lzandberg/SongBeam/Hardware/SongBeam3.1_back.jpg

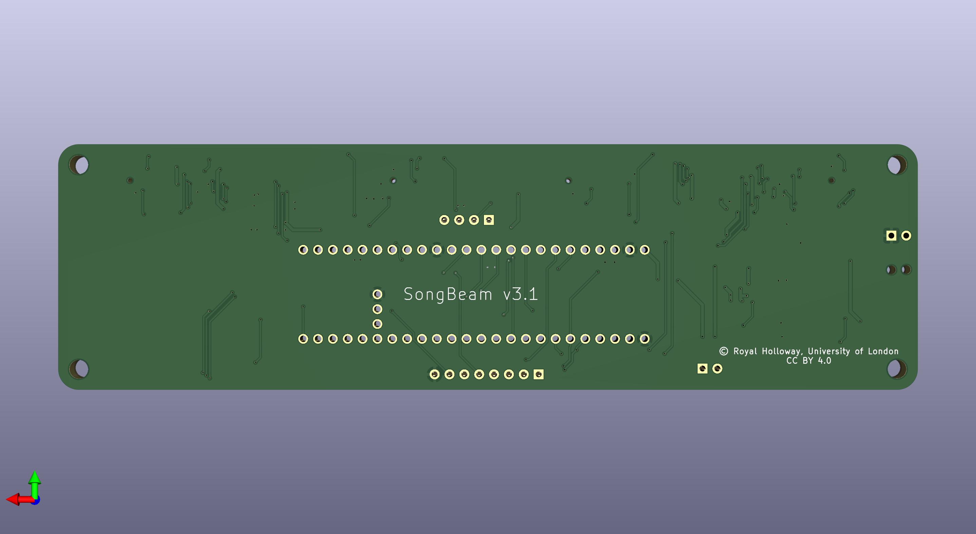
Hardware/SongBeam3.1_back.jpg
