lzandberg/SongBeam/Hardware/SongBeam3.1_front.jpg

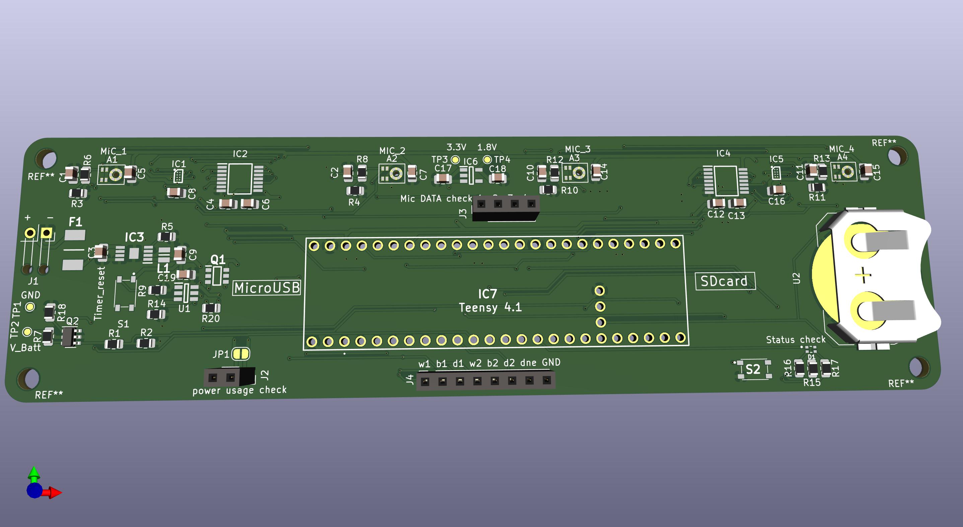
Hardware/SongBeam3.1_front.jpg
