lzandberg/SongBeam/README.md

# SongBeam
Songrecorder using beamforming technology
