lzandberg/SongBeam/Enclosure/IMG_0148.jpg

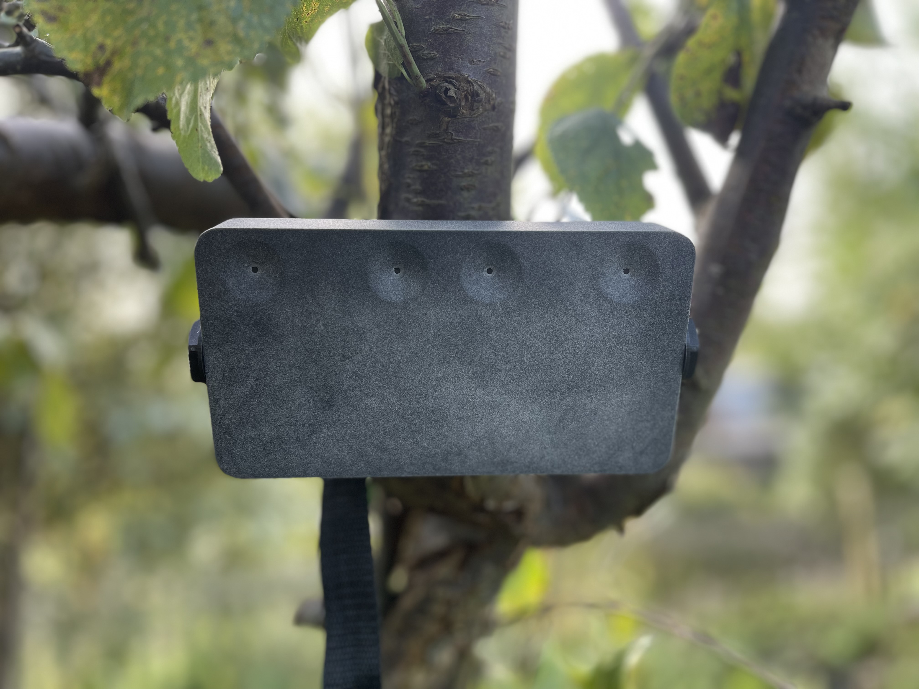
Enclosure/IMG_0148.jpg
