lzandberg/SongBeam/Enclosure/IMG_0149.jpg

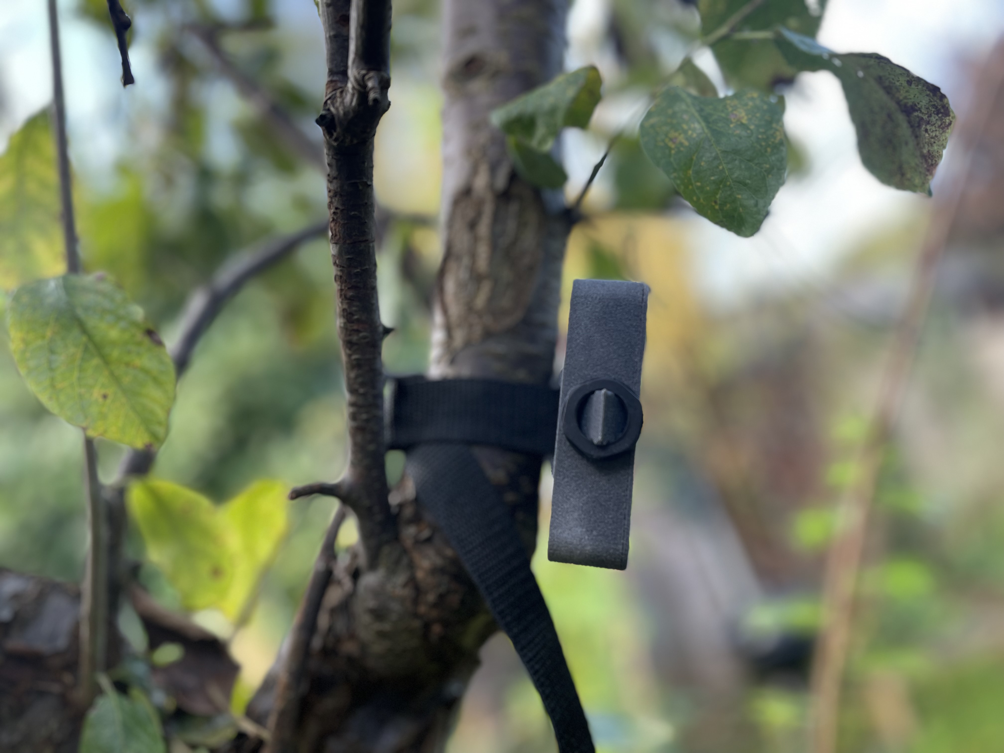
Enclosure/IMG_0149.jpg
