lzandberg/SongBeam/Enclosure/IMG_0150.jpeg

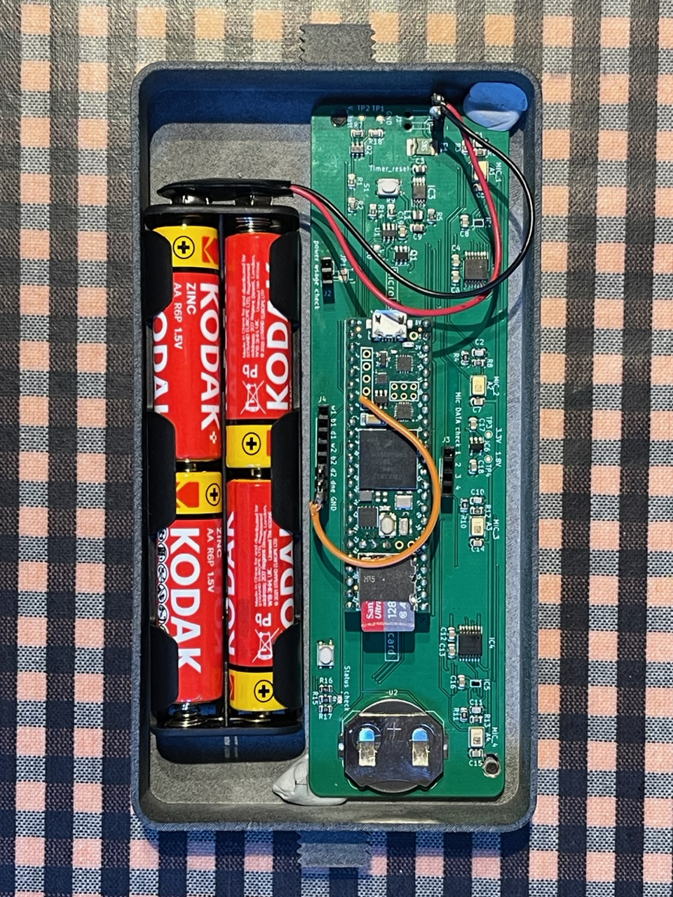
Enclosure/IMG_0150.jpeg
