lzandberg/SongBeam/Enclosure/SongBeam_Enclosure_Base.stl

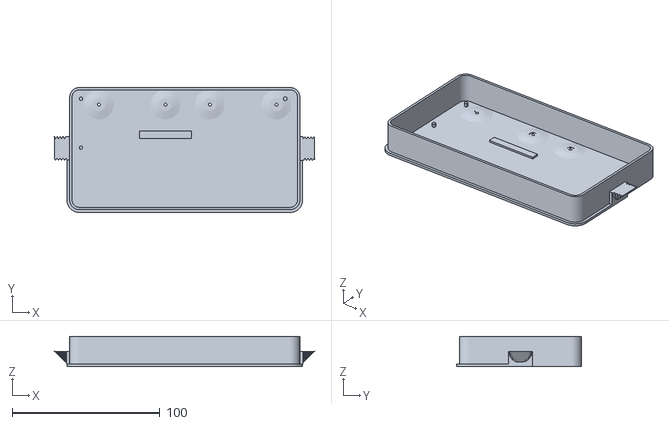
[picture p6: CAD file, 2023-12-08]
Enclosure/SongBeam_Enclosure_Base.stl
175.7 x 84.5 x 20.4
