lzandberg/SongBeam/Enclosure/SongBeam_Enclosure_Lid.stl

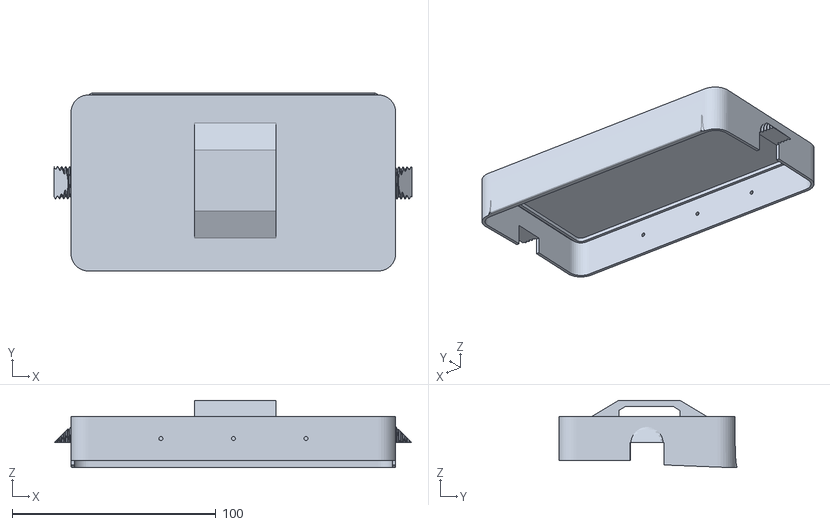
[picture p7: CAD file, 2023-12-08]
Enclosure/SongBeam_Enclosure_Lid.stl
175.7 x 87.4 x 33.1
