lzandberg/SongBeam/Hardware/SongBeam3.1.pdf

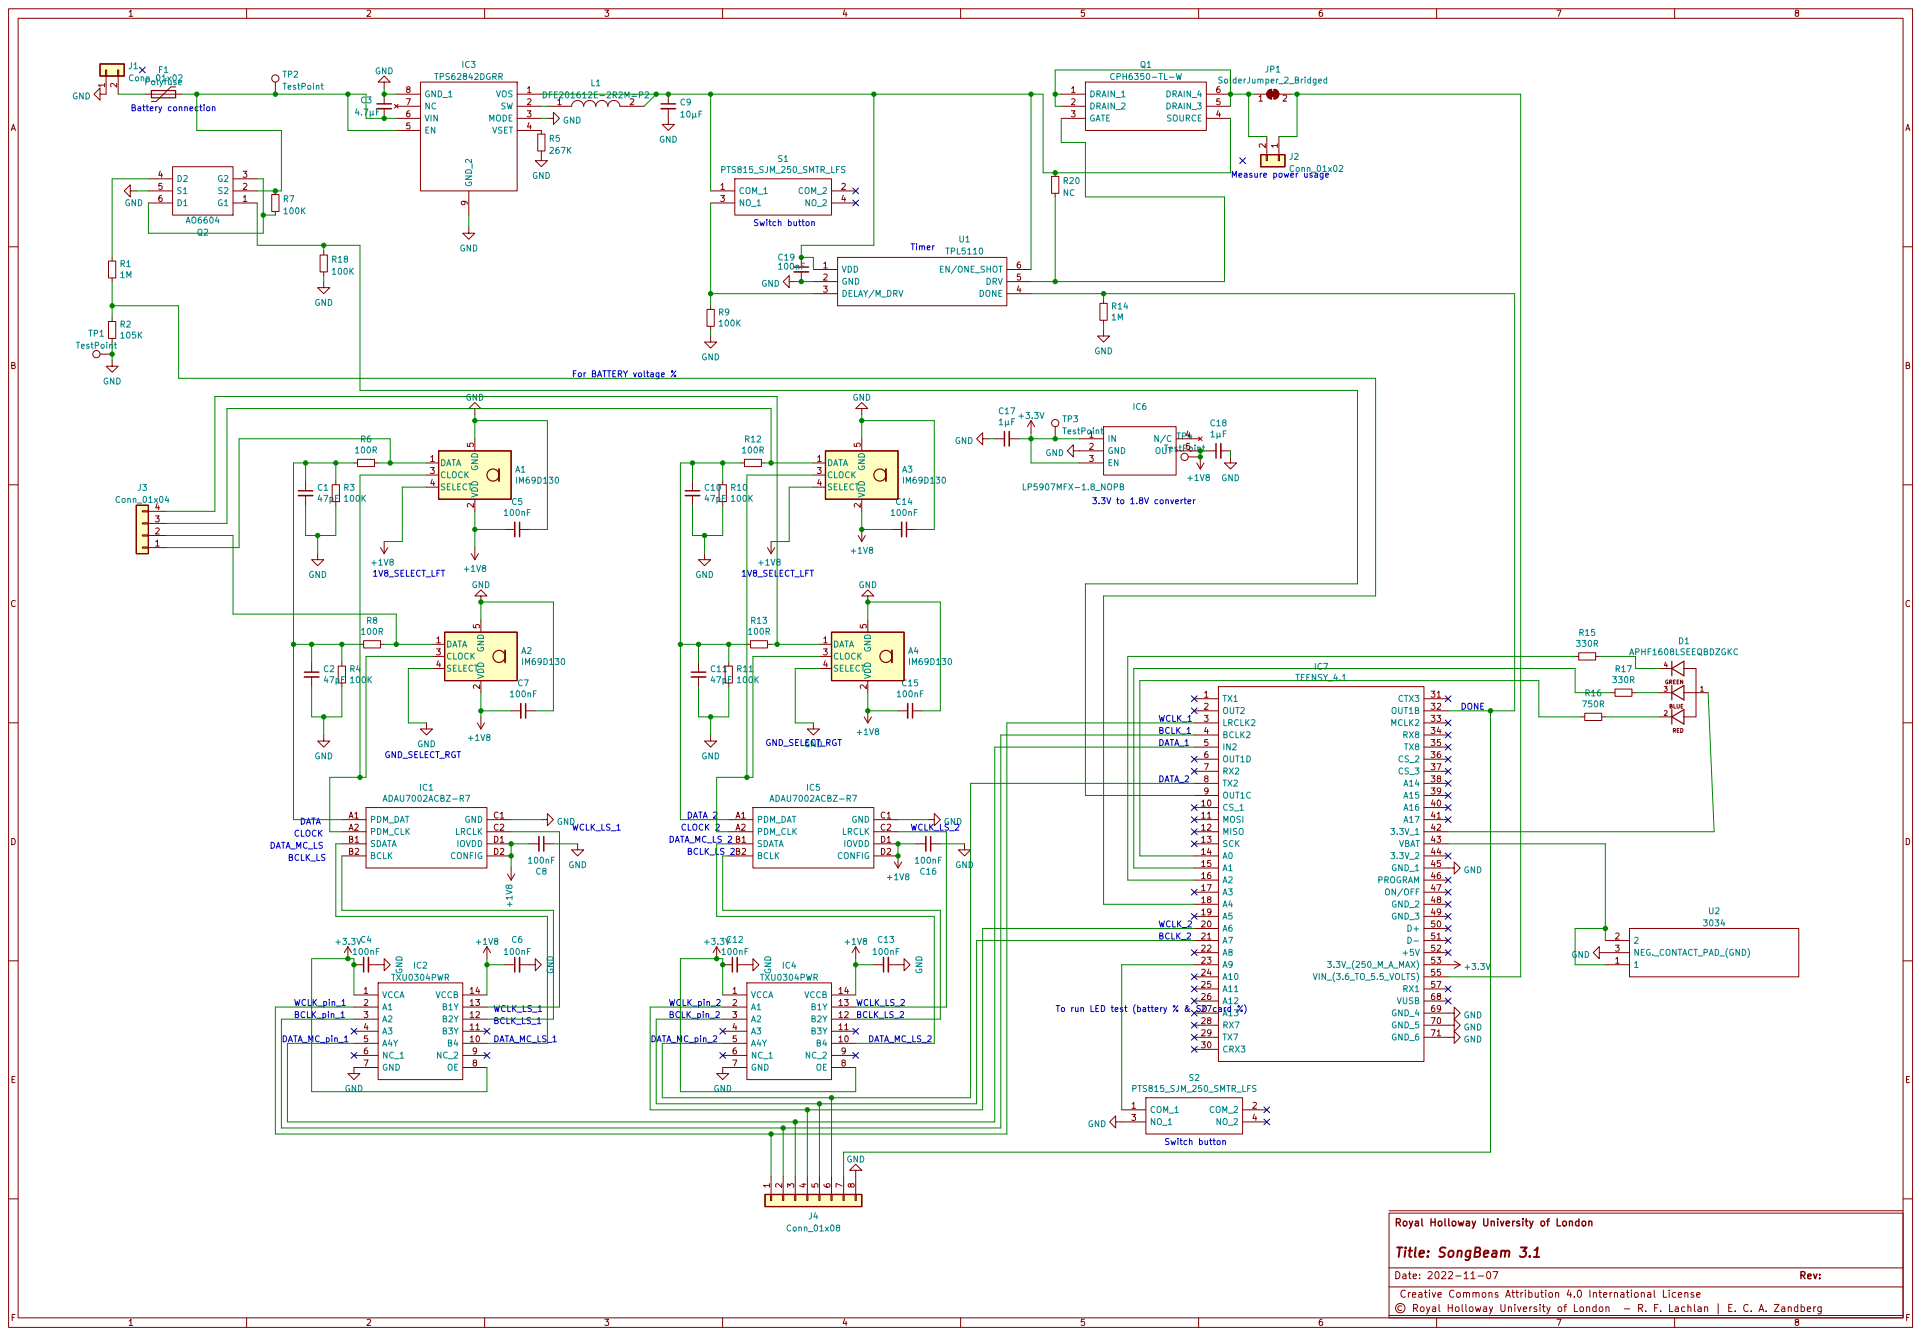
[picture p8: page 1]

To run LED test (battery % & SD card %) BCLK_2 WCLK_2 BCLK_LS 2 BCLK_pin_2

Royal Holloway University of London

Creative Commons Attribution 4.0 International License
