lzandberg/SongBeam/Hardware/SongBeam 3.1_kicad/SongBeam3.1.pdf

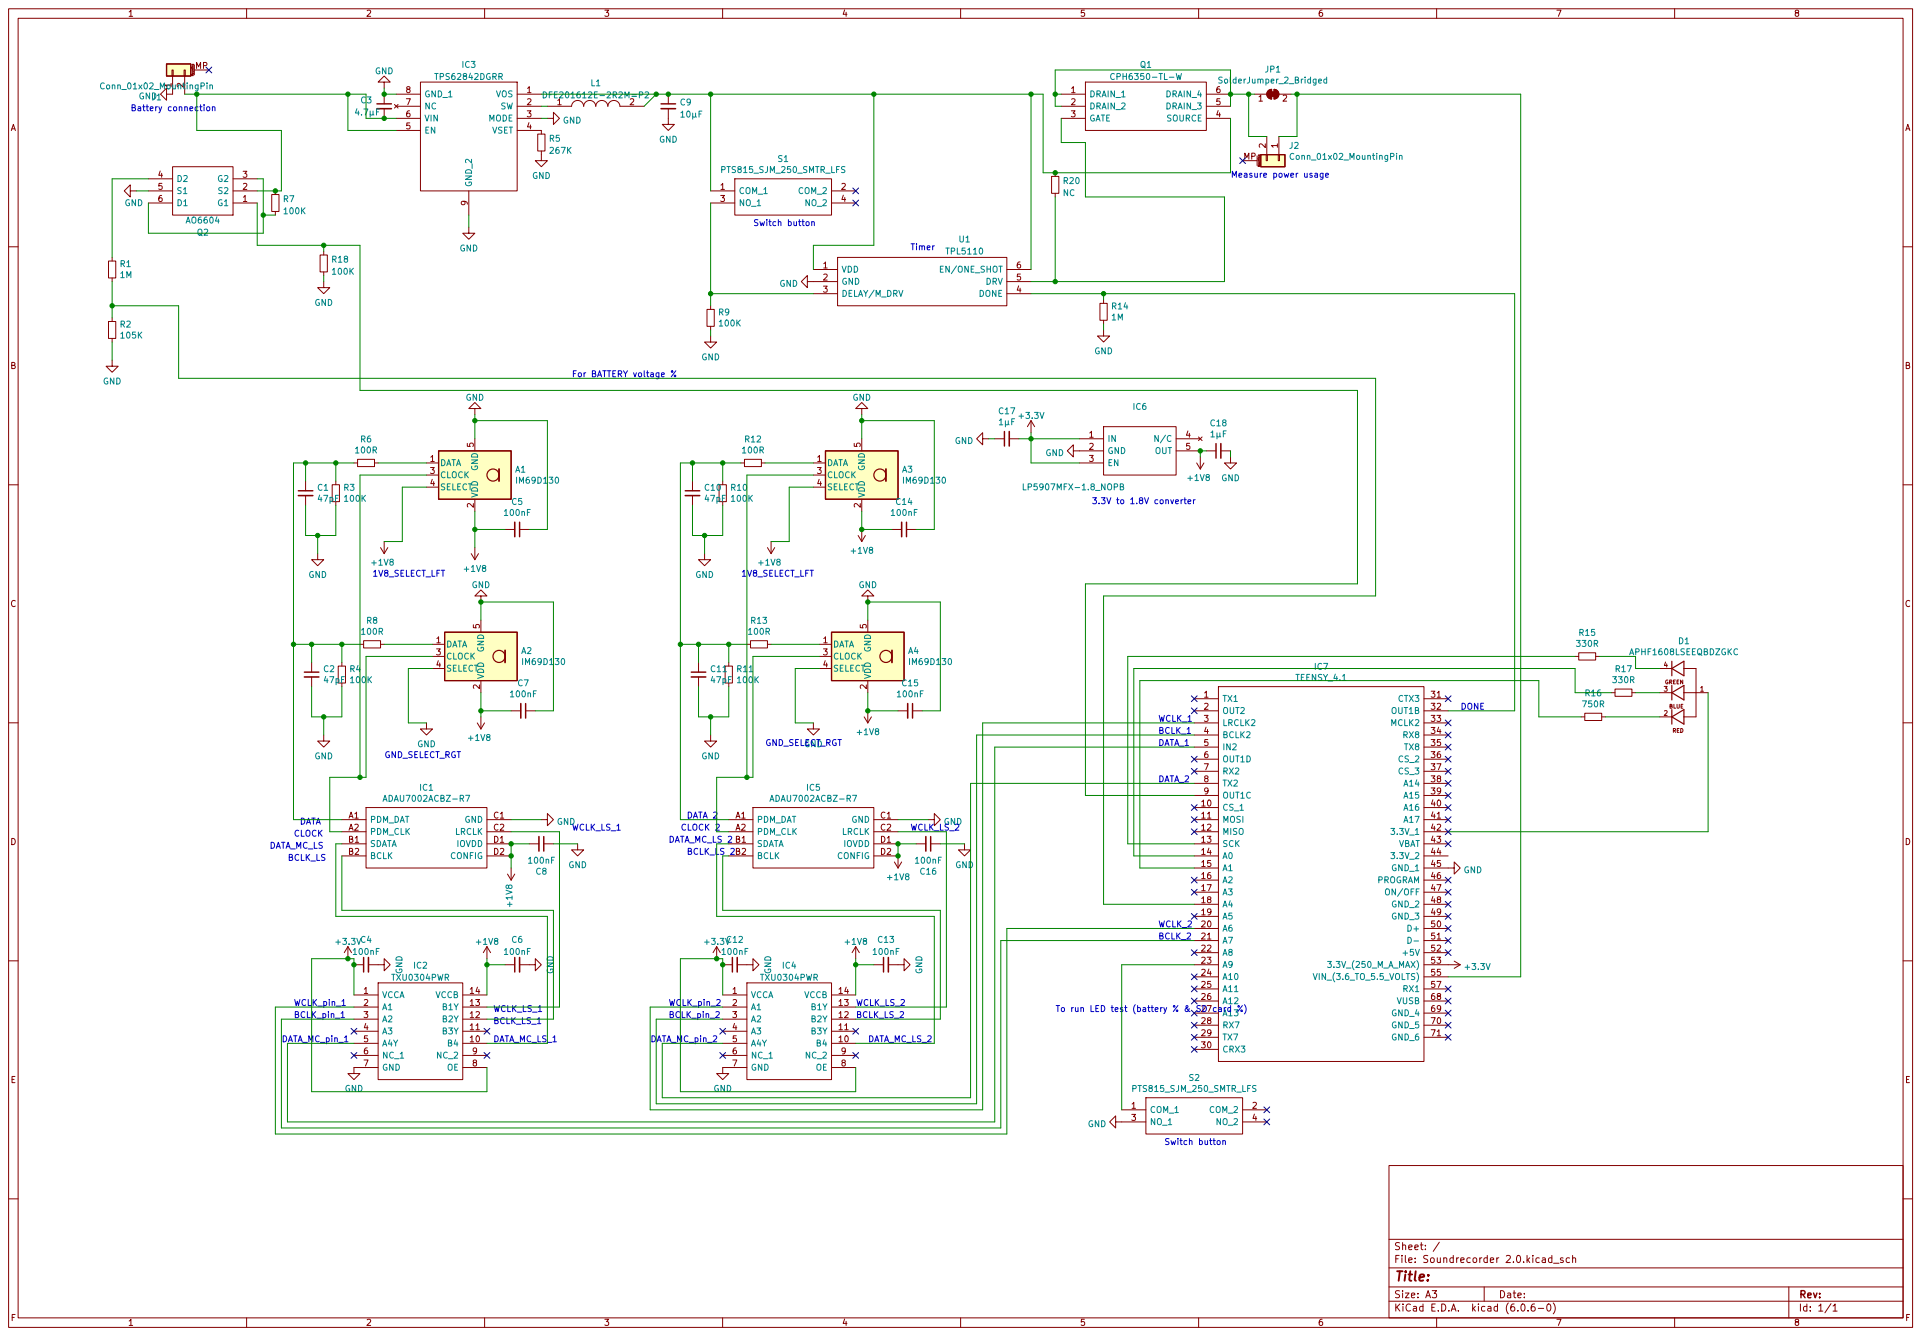
[picture p9: page 1]
