lzandberg/SongBeam/Hardware/SongBeam 3.1_kicad/SongBeam3.1.kicad_pcb

## KiCad design Hardware/SongBeam 3.1_kicad/SongBeam3.1.kicad_pcb (2022-12-05)

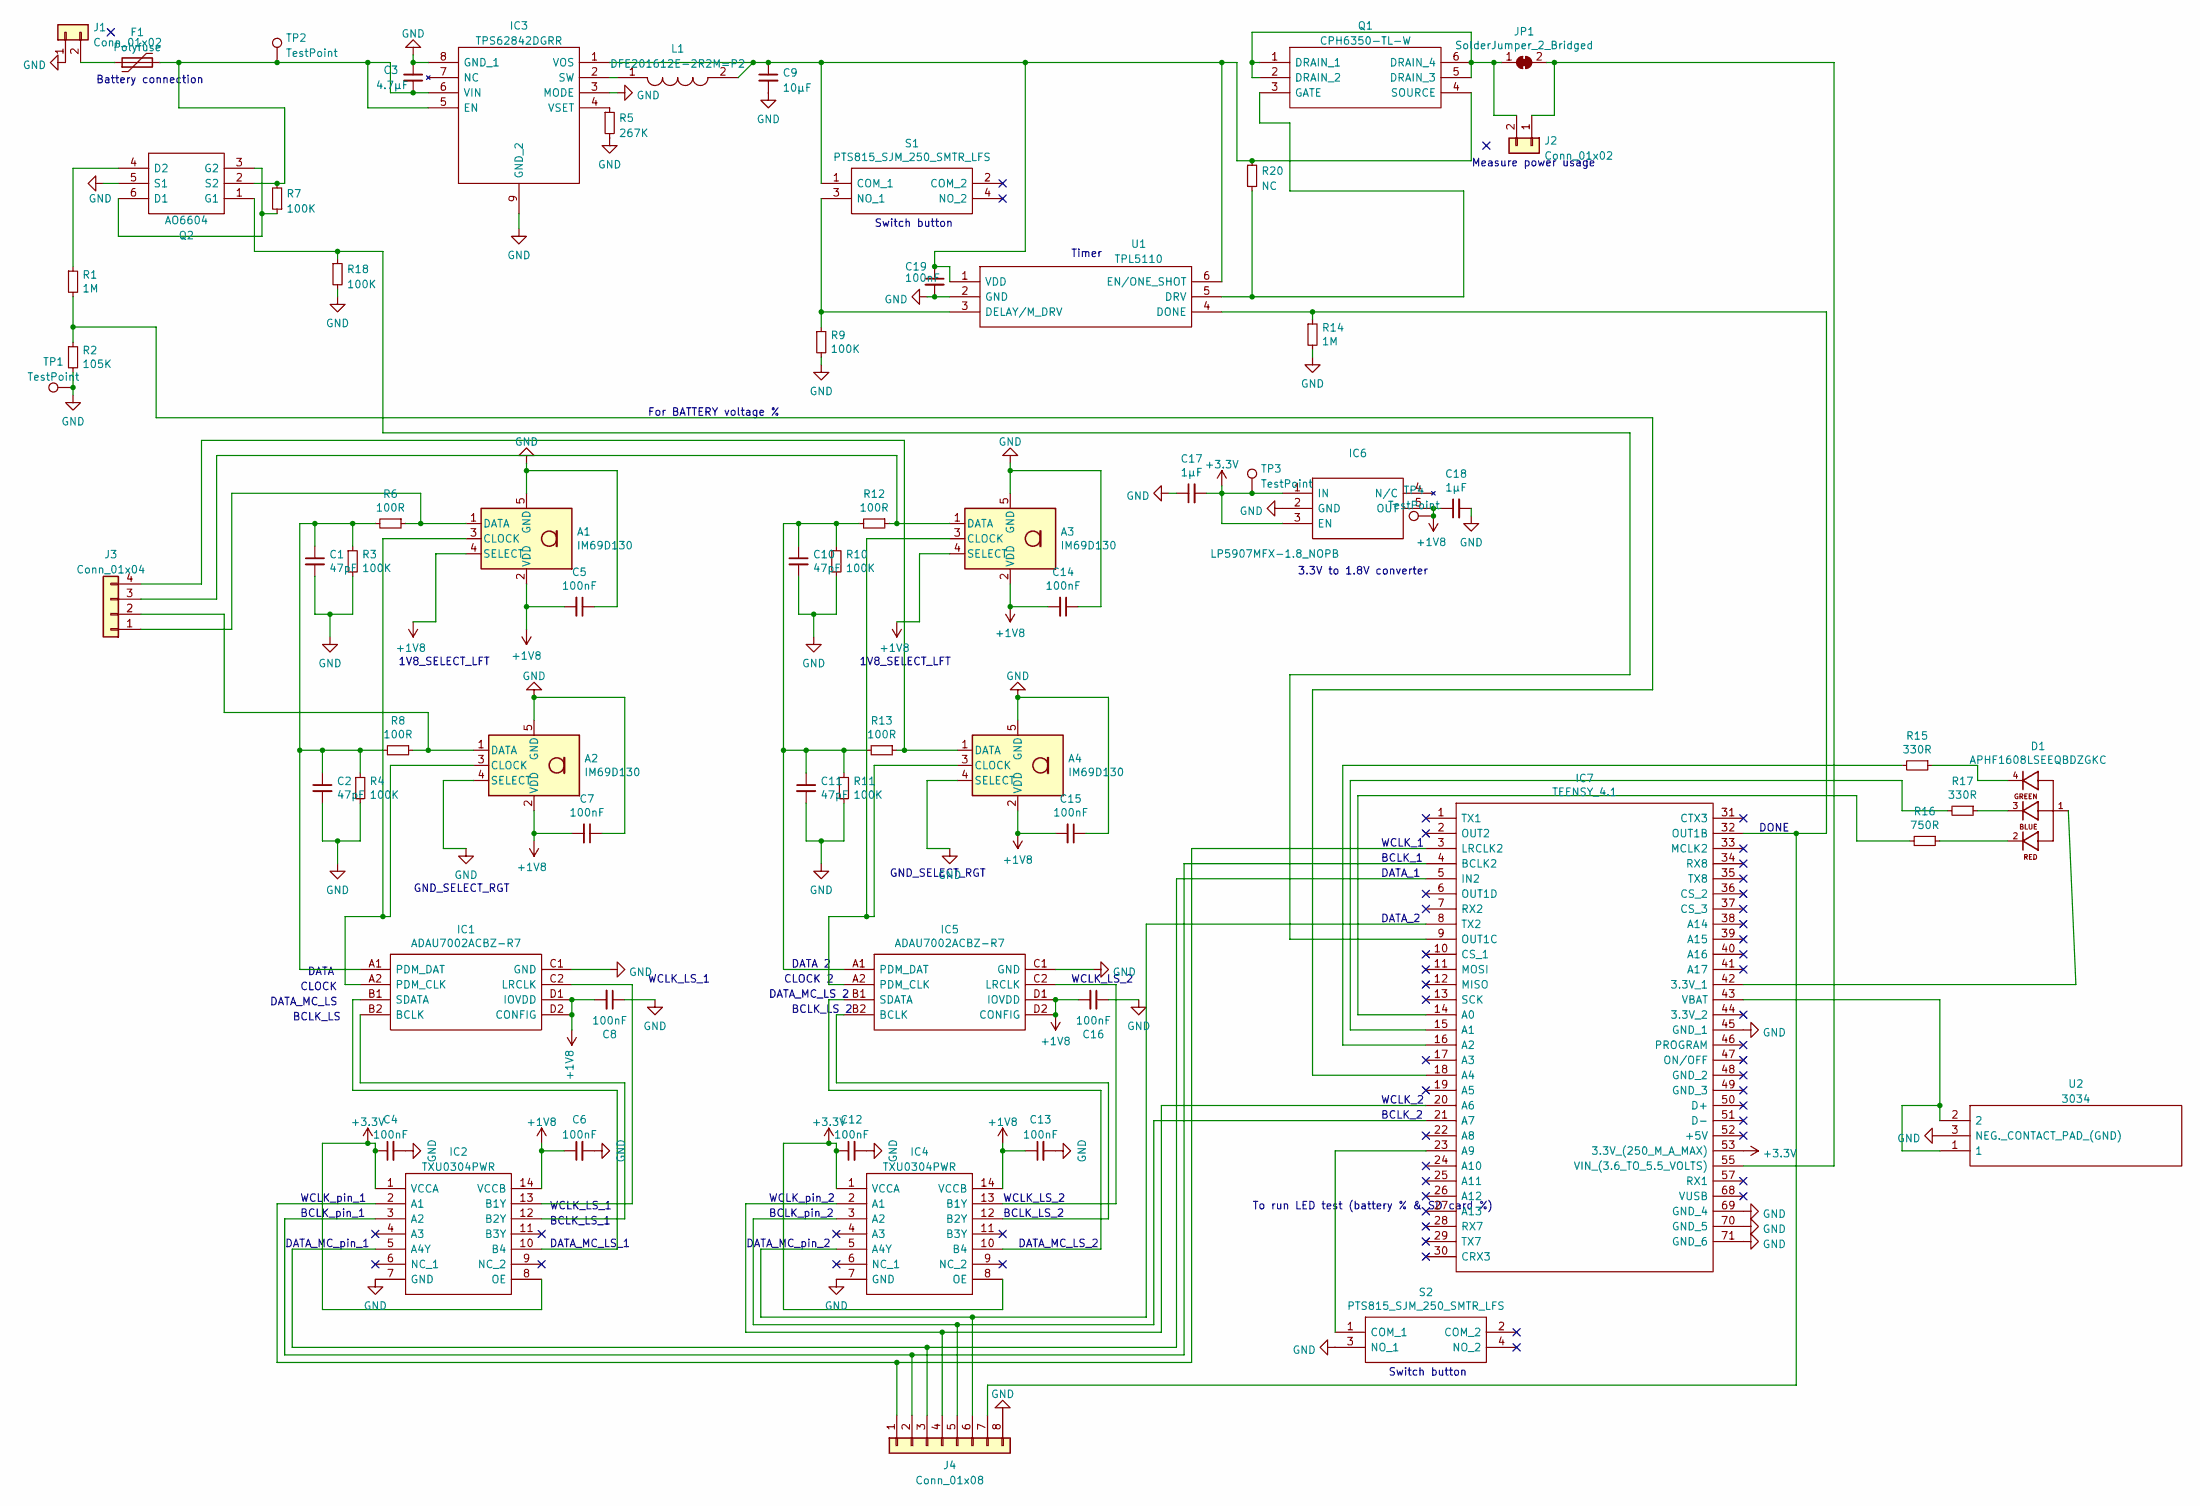
[picture p10: schematic SongBeam3.1.kicad_sch, SongBeam 3.1]

Parts:
A1, A2, A3, A4: IM69D130; Infineon_PG-LLGA-5-1; Manufacturer_Part_Number IM69D130V01XTSA1; Mouser Part Number 726-IM69D130V01XTSA1
C1, C2, C10, C11: 47pF; C_0805_2012Metric
C3: 4.7µF; C_0805_2012Metric
C4, C5, C6, C7, C8, C12, C13, C14, C15, C16, C19: 100nF; C_0805_2012Metric
C9: 10µF; C_0805_2012Metric
C17, C18: 1µF; C_0805_2012Metric
D1: APHF1608LSEEQBDZGKC; LED_APHF1608LSEEQBDZGKC; PARTREV V.3B; Mouser Part Number 604-APHF1608LQBDZGKC
F1: Polyfuse; MINISMDC050F2
IC1, IC5: ADAU7002ACBZ-R7; BGA8C40P2X4_76X156X56; Manufacturer_Part_Number ADAU7002ACBZ-R7; Mouser Part Number 584-ADAU7002ACBZ-R7
IC2, IC4: TXU0304PWR; SOP65P640X120-14N; Manufacturer_Part_Number TXU0304PWR; Mouser Part Number 595-TXU0304PWR
IC3: TPS62842DGRR; SOP65P490X110-9N; Manufacturer_Part_Number TPS62842DGRR; Mouser Part Number 595-TPS62842DGRR
IC6: LP5907MFX-1.8_NOPB; SOT95P280X145-5N; Manufacturer_Part_Number LP5907MFX-1.8/NOPB; Mouser Part Number 595-LP5907MFX-1.8NPB
IC7: TEENSY_4.1; TEENSY41; Manufacturer_Part_Number TEENSY 4.1
J1: Conn_01x02; SolderWire_1x02_P2.52
J2: Conn_01x02; PinSocket_1x02_P2.54mm_Vertical
J3: Conn_01x04; PinSocket_1x04_P2.54mm_Vertical
J4: Conn_01x08; PinSocket_1x08_P2.54mm_Vertical
JP1: SolderJumper_2_Bridged; SolderJumper-2_P1.3mm_Bridged_RoundedPad1.0x1.5mm
L1: DFE201612E-2R2M=P2; 1286ASH1R0MP2; Manufacturer_Part_Number DFE201612E-2R2M=P2; Mouser Part Number 81-DFE201612E-2R2MP2
Q1: CPH6350-TL-W; SOT95P280X105-6N; Manufacturer_Part_Number CPH6350-TL-W; Mouser Part Number 863-CPH6350-TL-W
Q2: AO6604; TSOP-6_1.65x3.05mm_P0.95mm; Manufacturer_Part_Number AO6604
R1, R14: 1M; R_0805_2012Metric
R2: 105K; R_0805_2012Metric
R3, R4, R7, R9, R10, R11, R18: 100K; R_0805_2012Metric
R5: 267K; R_0805_2012Metric
R6, R8, R12, R13: 100R; R_0805_2012Metric
R15, R17: 330R; R_0805_2012Metric
R16: 750R; R_0805_2012Metric
R20: NC; R_0805_2012Metric
S1, S2: PTS815_SJM_250_SMTR_LFS; PTS815SJM250SMTRLFS; Manufacturer_Part_Number PTS815 SJM 250 SMTR LFS; Mouser Part Number 611-PTS815SJM250SMTR
TP1, TP2, TP3, TP4: TestPoint; TestPoint_Pad_D1.0mm
U1: TPL5110; SOT95P280X110-6N; Manufacturer_Part_Number TPL5110DDCR; Mouser Part Number 595-TPL5110DDCR
U2: 3034; BatteryHolder_Keystone_3034_1x20mm; Manufacturer_Part_Number 3034; Mouser Part Number 534-3034

Connections:
+1V8: A1.2 (VDD), A1.4 (SELECT), A2.2 (VDD), A3.2 (VDD), A3.4 (SELECT), A4.2 (VDD), C5.2, C6.1, C7.2, C8.2, C13.1, C14.2, C15.2, C16.2, C18.1, IC1.D1 (IOVDD), IC1.D2 (CONFIG), IC2.14 (VCCB), IC4.14 (VCCB), IC5.D1 (IOVDD), IC5.D2 (CONFIG), IC6.5 (OUT), TP4.1
+3.3V: C4.1, C12.1, C17.2, IC2.1 (VCCA), IC2.8 (OE), IC4.1 (VCCA), IC4.8 (OE), IC6.1 (IN), IC6.3 (EN), IC7.53 (3.3V_(250_M_A_MAX)), TP3.1
GND: A1.5 (GND), A2.4 (SELECT), A2.5 (GND), A3.5 (GND), A4.4 (SELECT), A4.5 (GND), C1.2, C2.2, C3.1, C4.2, C5.1, C6.2, C7.1, C8.1, C9.2, C10.2, C11.2, C12.2, C13.2, C14.1, C15.1, C16.1, C17.1, C18.2, C19.2, IC1.C1 (GND), IC2.7 (GND), IC3.3 (MODE), IC3.8 (GND_1), IC3.9 (GND_2), IC4.7 (GND), IC5.C1 (GND), IC6.2 (GND), IC7.45 (GND_1), IC7.69 (GND_4), IC7.70 (GND_5), IC7.71 (GND_6), J1.1, J4.8, Q2.5 (S1), R2.2, R3.2, R4.2, R5.2, R9.2, R10.2, R11.2, R14.2, R18.2, S2.3 (NO_1), TP1.1, U1.2 (GND), U2.3 (NEG._CONTACT_PAD_(GND))
unnamed: A1.1 (DATA), J3.1, R6.1
unnamed: A1.3 (CLOCK), A2.3 (CLOCK), IC1.A2 (PDM_CLK)
unnamed: A2.1 (DATA), J3.2, R8.1
unnamed: A3.1 (DATA), J3.3, R12.1
unnamed: A3.3 (CLOCK), A4.3 (CLOCK), IC5.A2 (PDM_CLK)
unnamed: A4.1 (DATA), J3.4, R13.1
unnamed: C1.1, C2.1, IC1.A1 (PDM_DAT), R3.1, R4.1, R6.2, R8.2
unnamed: C3.2, F1.2, IC3.5 (EN), IC3.6 (VIN), Q2.2 (S2), R7.2, TP2.1
unnamed: C10.1, C11.1, IC5.A1 (PDM_DAT), R10.1, R11.1, R12.2, R13.2
unnamed: C9.1, C19.1, IC3.1 (VOS), L1.2, Q1.4 (SOURCE), R20.1, S1.1 (COM_1), U1.1 (VDD), U1.6 (EN/ONE_SHOT)
unnamed: D1.1, IC7.42 (3.3V_1)
unnamed: D1.2, R16.1
unnamed: D1.3, R17.1
unnamed: D1.4, R15.1
unnamed: F1.1, J1.2
unnamed: IC1.B1 (SDATA), IC2.10 (B4)
unnamed: IC1.B2 (BCLK), IC2.12 (B2Y)
unnamed: IC1.C2 (LRCLK), IC2.13 (B1Y)
unnamed: IC2.2 (A1), IC7.3 (LRCLK2), J4.1
unnamed: IC2.3 (A2), IC7.4 (BCLK2), J4.2
unnamed: IC2.5 (A4Y), IC7.5 (IN2), J4.3
unnamed: IC3.2 (SW), L1.1
unnamed: IC3.4 (VSET), R5.1
unnamed: IC4.2 (A1), IC7.20 (A6), J4.4
unnamed: IC4.3 (A2), IC7.21 (A7), J4.5
unnamed: IC4.5 (A4Y), IC7.8 (TX2), J4.6
unnamed: IC4.10 (B4), IC5.B1 (SDATA)
unnamed: IC4.12 (B2Y), IC5.B2 (BCLK)
unnamed: IC4.13 (B1Y), IC5.C2 (LRCLK)
unnamed: IC7.9 (OUT1C), Q2.1 (G1), R18.1
unnamed: IC7.14 (A0), R16.2
unnamed: IC7.15 (A1), R17.2
unnamed: IC7.16 (A2), R15.2
unnamed: IC7.18 (A4), R1.2, R2.1
unnamed: IC7.23 (A9), S2.1 (COM_1)
unnamed: IC7.32 (OUT1B), J4.7, R14.1, U1.4 (DONE)
unnamed: IC7.43 (VBAT), U2.1, U2.2
unnamed: IC7.55 (VIN_(3.6_TO_5.5_VOLTS)), J2.1, JP1.2 (B)
unnamed: J2.2, JP1.1 (A), Q1.1 (DRAIN_1), Q1.2 (DRAIN_2), Q1.5 (DRAIN_3), Q1.6 (DRAIN_4)
unnamed: Q1.3 (GATE), R20.2, U1.5 (DRV)
unnamed: Q2.3 (G2), Q2.6 (D1), R7.1
unnamed: Q2.4 (D2), R1.1
unnamed: R9.1, S1.3 (NO_1), U1.3 (DELAY/M_DRV)

Notes on the sheet:
BCLK_LS
DATA_MC_LS 2
DATA_MC_LS_2
WCLK_LS_1
Switch button
WCLK_pin_1
BCLK_LS_2
CLOCK 2
DATA_MC_LS
Battery connection
CLOCK
WCLK_2
BCLK_pin_1
WCLK_LS_2
3.3V to 1.8V converter
GND_SELECT_RGT
DATA 2
WCLK_1
BCLK_2
1V8_SELECT_LFT
To run LED test (battery % & SD card %)
DATA_MC_pin_1
BCLK_1
For BATTERY voltage %
BCLK_LS_1
WCLK_pin_2
DATA
Measure power usage
DATA_MC_LS_1
BCLK_LS 2
DATA_MC_pin_2
DONE
DATA_1
BCLK_pin_2
Timer
DATA_2

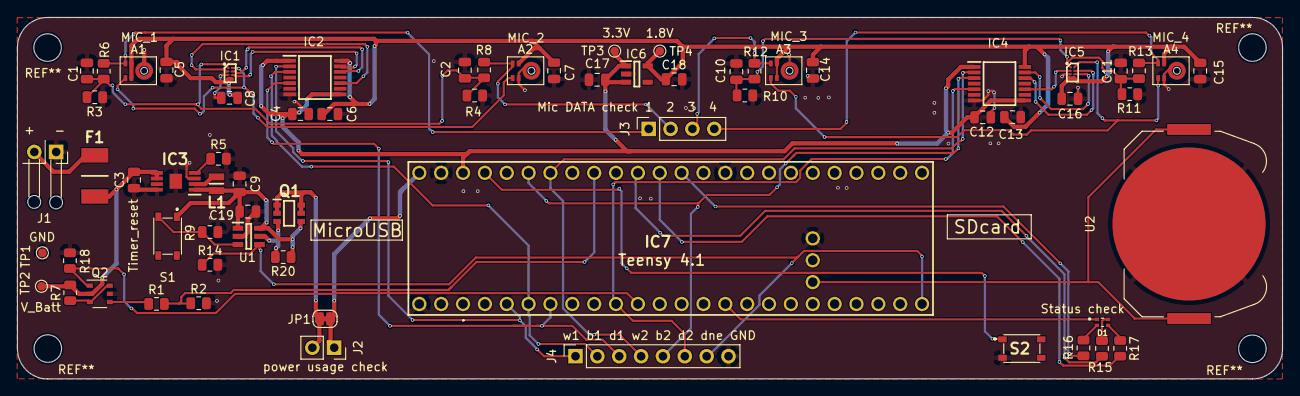
[picture p11: board SongBeam3.1.kicad_pcb from above]

Board: 2 copper layers, 147.0 x 42.0 mm, 67 parts (0 on the bottom side), 46 nets.
