lzandberg/SongBeam/(commit log)

2022-12-05 Initial commit
    Added files
    [SongBeam3.1.kicad_pcb, SongBeam3.1.kicad_sch, SongBeam3.1.sch, SongBeam3.1_old2.csv, SongBeam3.1x_old3.csv]
2022-12-05 Add hardware files
    [SongBeam3.1.kicad_pcb, SongBeam3.1.kicad_sch, SongBeam3.1.sch, SongBeam3.1_old2.csv, SongBeam3.1x_old3.csv]
2023-12-08 Add Enclosure files
    [SongBeam_Enclosure_Base.stl, SongBeam_Enclosure_Lid.stl]
2023-12-08 Update README Enclosure.txt
