lzandberg/SongBeam/(notices)

Notices in the files:
Hardware/SongBeam 3.1_kicad/SongBeam3.1.kicad_pcb:
CC BY 4.0
